swarren/logo-turtle/(commit log)

2017-02-08 Fix cut/paste error in (c) messages
    [turtle.scad]
2017-02-08 Convert ESP8266 code to Arduino
    - Disable DEBUG in the real Arduino sketch; it interferes with automating
    command submission from the ESP8266.
    - Print a known delimiter after each command response for easy
    synchronization with the ESP8266.
    - Add ESP8266 Arduino-based code, with command submission via HTTP.
    It's far easier to recompile and download the ESP8266 code using the
    Arduino IDE vs. the native ESP8266 SDK.
    - Convert Python library to use HTTP command submission.
    [turtle-esp8266.ino, turtle.ino, wdoturtle.py]
